igrowing/Orchids/hardware/rpi_orchids.sch

## EAGLE design hardware/rpi_orchids.sch (2017-02-25)

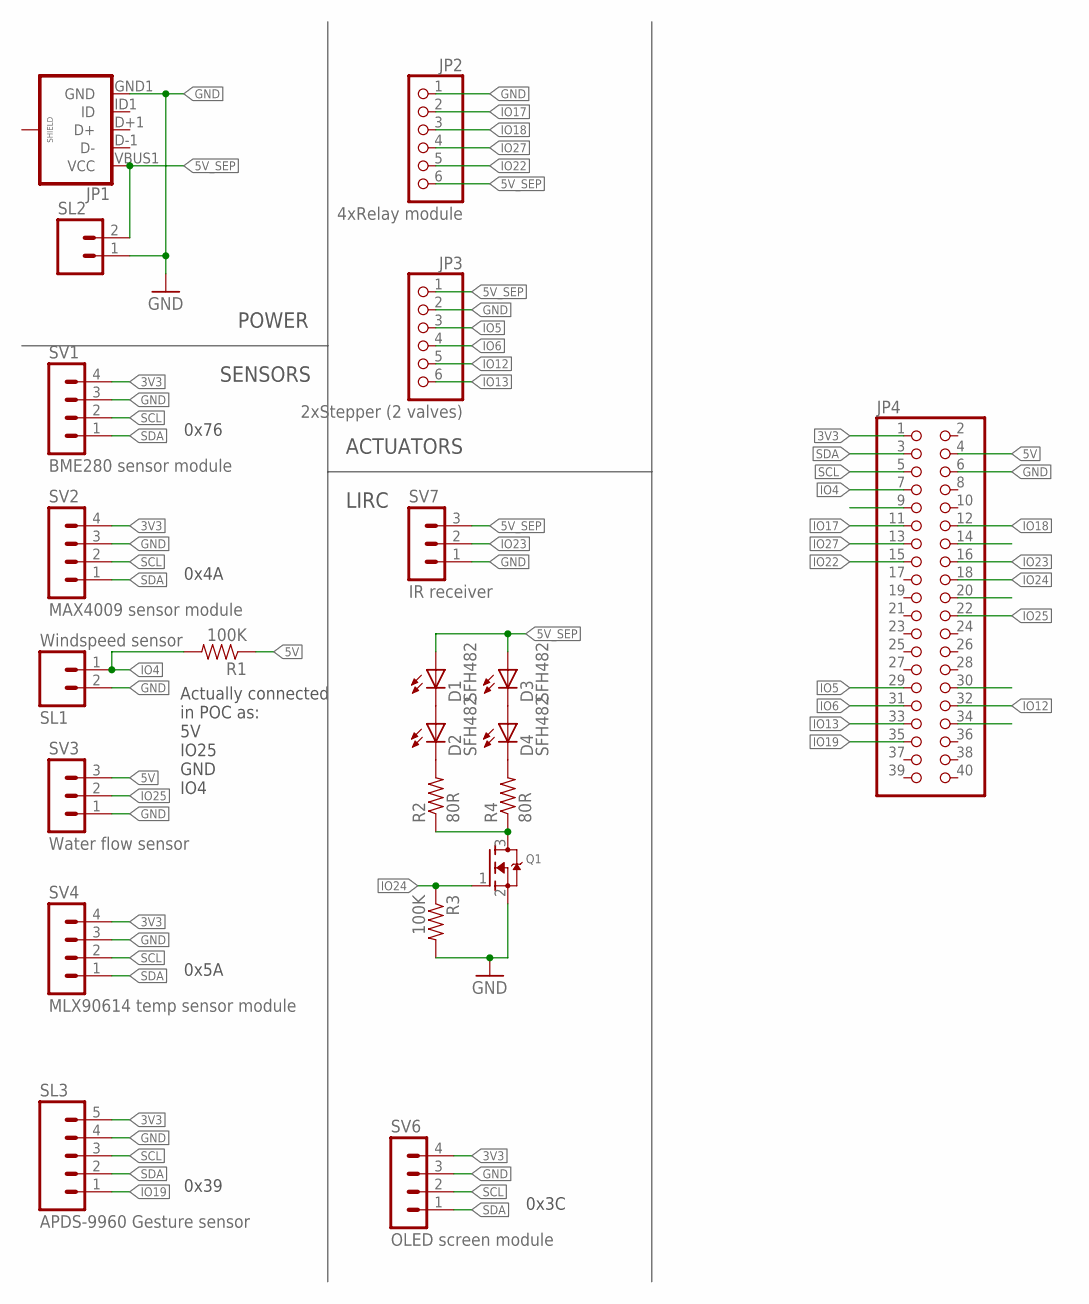
[picture p1: schematic rpi_orchids.sch]

Parts:
D1, D2, D3, D4: SFH482
JP1: USB_MICROB_PLUGCONN-11752; USB-B-MICRO-SMD_V03
JP2: 4xRelay module; 1X06
JP3: 2xStepper (2 valves); 1X06
JP4: PINHD-2X20; 2X20
Q1: MOSFET-NREFLOW; SOT23
R1, R3: 100K; 0603-RES
R2, R4: 80R; 0603-RES
SL1: Windspeed sensor; 02PA
SL2: MA02; 02PA
SL3: APDS-9960 Gesture sensor; 05PA
SV1: BME280 sensor module; MA04-1
SV2: MAX4009 sensor module; MA04-1
SV3: Water flow sensor; MA03-1
SV4: MLX90614 temp sensor module; MA04-1
SV6: OLED screen module; MA04-1
SV7: IR receiver; MA03-1

Connections:
3V3: JP4.1, SL3.5, SV1.4, SV2.4, SV4.4, SV6.4
5V: JP4.4, R1.1, SV3.3
5V_SEP: D1.A, D3.A, JP1.VBUS1 (VCC), JP2.6, JP3.1, SL2.2, SV7.3
GND: JP1.GND1 (GND), JP2.1, JP3.2, JP4.6, Q1.2 (S), R3.2, SL1.2, SL2.1, SL3.4, SV1.3, SV2.3, SV3.1, SV4.3, SV6.3, SV7.1
IO4: JP4.7, R1.2, SL1.1
IO5: JP3.3, JP4.29
IO6: JP3.4, JP4.31
IO12: JP3.5, JP4.32
IO13: JP3.6, JP4.33
IO17: JP2.2, JP4.11
IO18: JP2.3, JP4.12
IO19: JP4.35, SL3.1
IO22: JP2.5, JP4.15
IO23: JP4.16, SV7.2
IO24: JP4.18, Q1.1 (G), R3.1
IO25: JP4.22, SV3.2
IO27: JP2.4, JP4.13
unnamed: D3.K (C), D4.A
unnamed: D1.K (C), D2.A
unnamed: D2.K (C), R2.2
unnamed: D4.K (C), R4.2
unnamed: Q1.3 (D), R2.1, R4.1
SCL: JP4.5, SL3.3, SV1.2, SV2.2, SV4.2, SV6.2
SDA: JP4.3, SL3.2, SV1.1, SV2.1, SV4.1, SV6.1

Notes on the sheet:
POWER
SENSORS
LIRC
ACTUATORS
0x76
0x4A
0x5A
0x39
0x3C
Actually connected in POC as: 5V IO25 GND IO4
