igrowing/Orchids/(threads)

Thread 1 (2017-02-22):

Bootstrap module doesn't load

igrowing, 2017-02-22:
```
$ m runserver 0.0.0.0:8001
Unhandled exception in thread started by <function wrapper at 0x761137f0>
Traceback (most recent call last):
  File "/usr/local/lib/python2.7/dist-packages/django/utils/autoreload.py", line 226, in wrapper
    fn(*args, **kwargs)
  File "/usr/local/lib/python2.7/dist-packages/django/core/management/commands/runserver.py", line 113, in inner_run
    autoreload.raise_last_exception()
  File "/usr/local/lib/python2.7/dist-packages/django/utils/autoreload.py", line 249, in raise_last_exception
    six.reraise(*_exception)
  File "/usr/local/lib/python2.7/dist-packages/django/utils/autoreload.py", line 226, in wrapper
    fn(*args, **kwargs)
  File "/usr/local/lib/python2.7/dist-packages/django/__init__.py", line 27, in setup
    apps.populate(settings.INSTALLED_APPS)
  File "/usr/local/lib/python2.7/dist-packages/django/apps/registry.py", line 85, in populate
    app_config = AppConfig.create(entry)
  File "/usr/local/lib/python2.7/dist-packages/django/apps/config.py", line 90, in create
    module = import_module(entry)
  File "/usr/lib/python2.7/importlib/__init__.py", line 37, in import_module
    __import__(name)
ImportError: No module named bootstrap3

```

igrowing, 2017-02-24:
pip install django-bootstrap3
Plus unpack the boostrap archive into orchid_app/static/bootstrap/

Now failing at
NoReverseMatch at /

igrowing, 2017-02-24:
Bootstrap loaded. Not used thus.

Closed 2017-02-24.

Thread 3 (2017-03-16):

Sensor table data is time ordered

igrowing, 2017-03-16:
Make it in reverse time order.

igrowing, 2017-03-21:
.order_by('-date') works to reverse the data order.

Closed 2017-03-21.

Thread 9 (2017-03-26):

Do not run actuators/actions if no change

igrowing, 2017-03-26:
Avoid extra tempering of actuators and extra records in the DB.
Read the last record first. If required action == last recorded action then skip.

Closed 2017-03-27.

Thread 12 (2017-05-08):

Add alert "No water running when expected"

igrowing, 2017-05-08:

igrowing, 2017-05-13:
This is tricky: when mist on the water flow is miserable --> 0.
Avoid false alerts.

Closed 2017-06-02.

Thread 14 (2017-05-18):

Add low pass filter to water leakage alert

igrowing, 2017-05-18:

igrowing, 2017-05-19:
Added.

Closed 2017-05-19.
