igrowing/Orchids/orchid_app/sensors/yf_201s.py

#!/usr/bin/env python
'''
Water flow sensor.
Publish to MQTT passed water in liters every second, minute, hour, day.

Author: Igor Yanyutin.
'''

import time
import RPi.GPIO as GPIO
import subprocess as sp

# Get ready to post MQTT status. Install the library first.
# sudo pip install paho-mqtt
import paho.mqtt.publish as publish

pin = 25
# YF-201s sensor is documented with 450 ticks/liter. Practical measure shows approx. 75 ticks/liter (div. by 6).
TICKS_L = 450.0 / 7.8  # Keep decimal for parts of liters
GPIO.setwarnings(False)  # Disable warnings
GPIO.setmode(GPIO.BCM)
GPIO.setup(pin, GPIO.IN, pull_up_down=GPIO.PUD_UP)
_counter_s = 0
_counter_m = 0
_counter_h = 0
_counter_d = 0

def run():
    '''Poll sensor, count ticks, update MQTT every second of progress.'''
    s = m = h = d = time.time()
    global _counter_s, _counter_m, _counter_h, _counter_d
    while True:
        # sp.Popen(['logger', 'Read water'], stdout=sp.PIPE, stderr=sp.PIPE).communicate()  # Debug msg
        # Increase counter only in case of actual trigger, not timeout.
        try:  # Weird workaround for "Error: waiting for edge" :-(
            if GPIO.wait_for_edge(pin, GPIO.FALLING, bouncetime=1, timeout=1000):  # times in ms
                _counter_s += 1
        except RuntimeError:
            continue
        if time.time() - s > 1:   # more than a sec
            publish.single("shm/orchid/water/last_sec", _counter_s / TICKS_L, retain=False, hostname="localhost")
            s = time.time()
            _counter_m += _counter_s
            _counter_s = 0
        if time.time() - m > 60:   # more than a min
            publish.single("shm/orchid/water/last_min", _counter_m / TICKS_L, retain=False, hostname="localhost")
            m = time.time()
            _counter_h += _counter_m
            _counter_m = 0
        if time.time() - h > 3600:   # more than a hour
            publish.single("shm/orchid/water/last_hour", _counter_h / TICKS_L, retain=False, hostname="localhost")
            h = time.time()
            _counter_d += _counter_h
            _counter_h = 0
        if time.time() - d > 86400:   # more than a day
            publish.single("shm/orchid/water/last_day", _counter_d / TICKS_L, retain=False, hostname="localhost")
            d = time.time()
            _counter_d = 0


# Use this trick to execute the file. Normally, it's a module to be imported.
if __name__ == "__main__":
    print 'Subscribe to data with:'
    print 'mosquitto_sub -v -t "#"'
    print 'Search for water :)'
    run()
