igrowing/Orchids/(commit log)

2017-02-25 Added manual control of actuators. Ugly view, bootstrap3 still doesn't work.
    [valve.py]
2017-02-25 Added schematics of HAT.
    [rpi_orchids.sch]
2017-03-04 added runner command. Workarounded GPIO problem.
    [anemometer.py, runner.py, yf_201s.py]
2017-03-04 Both valves work. Added active_low parameter.
2017-03-12 Added paginated display of sensors data.
2017-03-16 Present Date and Time in the sensors table. Hide ID column.
2017-03-18 Added 1st and last page in data of sensors.
2017-03-18 Calibrated anemometer.
2017-03-18 Optimized the data collection from sensors, included averaging, stuck-rpoofing.
    [runner.py]
2017-03-19 Crash protection for runner command added.
    [runner.py]
2017-03-19 Shut off actuators on system start added.
2017-03-25 Water flow sensor calibrated.
2017-03-26 Added reasoning for actuators change. Added water leakage detector. Some refactor.
    [runner.py]
2017-03-26 Bug fix: Water flow is measured in the table as average
    [runner.py]
2017-03-27 Bugfix in actions page. Issue resolved: Do not run actuators/actions if no change
2017-04-02 Added forced save of actuator change for non-regular workflow.
2017-04-03 better water sensor calibration
2017-04-23 Added leakage detection while all valves closed
    [runner.py]
2017-04-29 Calculate current state in runner.
2017-05-02 Reduce sensitivity of water max flow rate detection.
2017-05-06 Added automated decision making. Still not called and not threaded.
2017-05-09 Bug fix of refresh of current state representation in views.py.
2017-05-12 Calibrated light sensor. Cosmetic UI changes.
2017-05-13 User actions Timer added and exposed to UI.
2017-05-13 Bugfixes: averaging of state, timer. Excessive prints removed.
    [runner.py]
2017-05-15 Added water leakage alarm immunity, avoid false alarm.
    [runner.py]
2017-05-17 Bugfixes in timer function
    [runner.py]
2017-05-17 Bugfix of water leakage detection
    [runner.py]
2017-05-19 Improve leakage alert immunity
    [runner.py]
2017-05-19 Add report to /var/log/messages about CPU overheat
    [runner.py]
2017-05-19 Improve error handling on work with DB
    [runner.py]
2017-05-21 Remove excessive prints, improve kealage alert immunity, increase performance
2017-05-24 FW update function fixed.
    [runner.py]
2017-05-26 Bugfix in runner: timer was triggering shut off for any action
    [runner.py]
2017-05-27 Bugfixes in automation: turn off non-relevant for current state devices.
2017-05-28 Move timer functionality from runner to controller. Disable all automation for debug. Add some prints. Improve get_next_action().
2017-05-28 Added timer reading from DB to get_last_automated_action: timer off is also automate.
2017-05-30 Timer moved to controller as separated function. Not called yed.
2017-05-31 Timer works as a part of main loop.
2017-05-31 Added debug prints. Attempt to fix timer: the automate was running in spite timer is active.
2017-06-02 Remove excessive prints. Report state change.
2017-06-02 Feature added: stop automation if any actuator enabled manually. Send alerts once in hour if manual action is not disabled in 1 hour.
2017-06-03 Bigfix: don't show timer when automated action works.
2017-06-03 Bugfix in sanity check: exclude fan when fan and mist to be on.
2017-06-07 Empiric update to mist and fan actions.
